vanhoang1809/WATER_QUALITY_SYSTEM/webSocket_sourceCode/Package/images/kitchen.jpg

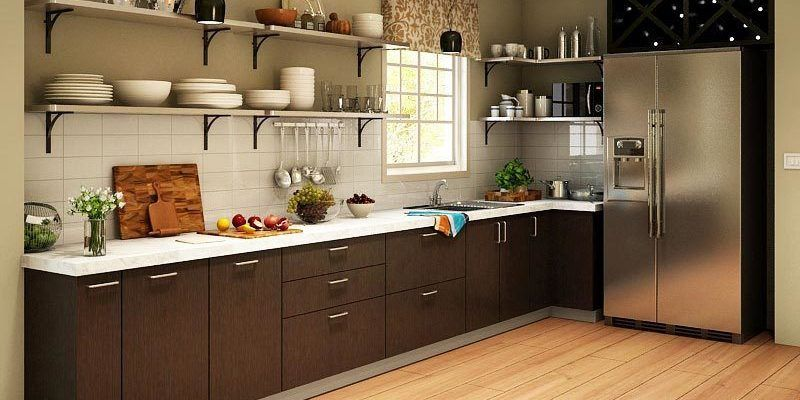
webSocket_sourceCode/Package/images/kitchen.jpg
