vanhoang1809/WATER_QUALITY_SYSTEM/webSocket_sourceCode/Package/images/bed.jpg

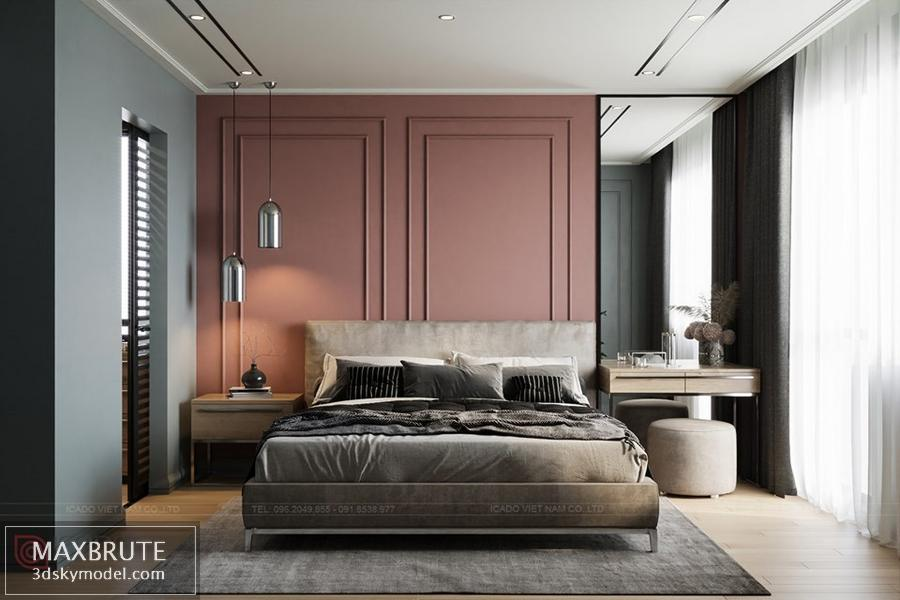
webSocket_sourceCode/Package/images/bed.jpg
