vanhoang1809/WATER_QUALITY_SYSTEM/README.md

### This is Source Code and demo video of BUILDING WATER QUALITY ANALYSIS AND MONITORING SYSTEM Project 
1. I have summarized briefly the project content in the slide (Document folder) and detailed water quality assessment standards in the report file.
2. Link Video demo: **[Please click Here](https://drive.google.com/file/d/1CBfUh1bPnyKN_S8XS4h3YwOBiLn6Hz4U/view?usp=sharing)**
3. If you have any questions about my source code, please contact:
   > - Phone: 0352571646
   > - Email: vvhoang18092001@gmail.com

##### _Wish you success on the path you have chosen!_
