vanhoang1809/WATER_QUALITY_SYSTEM/webSocket_sourceCode/Package/images/living.jpg

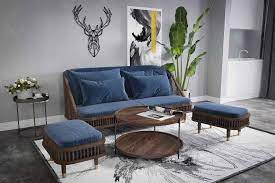
webSocket_sourceCode/Package/images/living.jpg
