vanhoang1809/WATER_QUALITY_SYSTEM/webSocket_sourceCode/Package/images/nhietdo.png

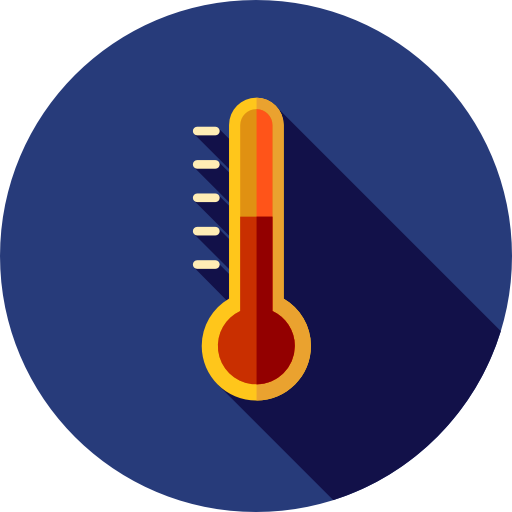
webSocket_sourceCode/Package/images/nhietdo.png
