vanhoang1809/WATER_QUALITY_SYSTEM/webSocket_sourceCode/Package/images/people-walking-dog-coppy.jpg

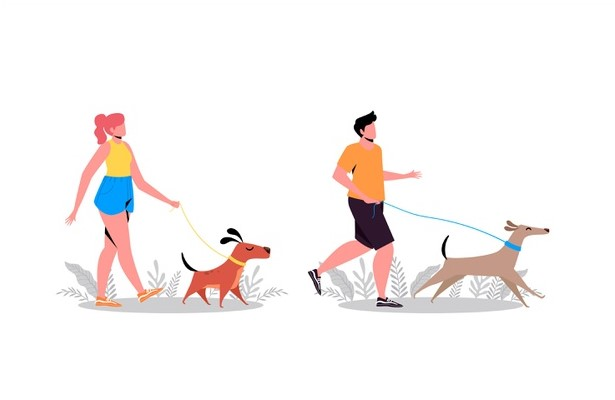
webSocket_sourceCode/Package/images/people-walking-dog-coppy.jpg
