vanhoang1809/WATER_QUALITY_SYSTEM/webSocket_sourceCode/Package/images/pH7-Design.png

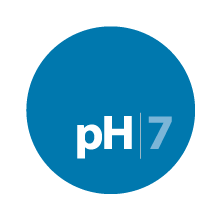
webSocket_sourceCode/Package/images/pH7-Design.png
